LeJiPe/THN132N-BAR626/README.md

##  L'énigme du sphinx Oregon 
## 🛠️ 1 - comment j'ai fini par percer le CRC des sondes THN132N/THN122 avec une carte son
## 🛠️ 2 - Amélioration de la Station BAR626 : Remplacement du Récepteur par un SRX882

## Le problème

Avec des amis, nous possédons tous un récepteur météo Oregon Scientific **BAR626**. Le souci est que ses sondes extérieures d'origine du constructeur — THN132N, THN122,  — tombent en panne au bout de quelques années, et sont aujourd'hui introuvables sur le marché. Les fabricants chinois n'ont jamais copié cette sonde. Aucune sonde du commerce actuelle n'est compatible avec ce récepteur.

Ce n'est pas faute d'avoir cherché du côté de la communauté : sur GitHub et ailleurs, plusieurs personnes butent depuis longtemps sur le calcul du CRC de ces trames. Des tables de relevés partielles existent, mais aucune ne s'est révélée compatible à 100 % avec le récepteur.

Je ne suis ni informaticien ni électronicien de formation. Mais j'avais encore une dernière sonde THN132N vivante, et je me suis dit qu'il devait bien y avoir moyen de comprendre ce qu'Oregon avait imaginé.

## Le robot "Enigma Oregon"

Pour faire parler cette dernière sonde survivante, j'ai construit un robot de test : des potentiomètres à la place des CTN, montés sur des servomoteurs pour balayer un grand nombre de valeurs de température , et des relais pour piloter les canaux.

Le robot a tourné pendant **3 jours** — cliquetis des relais, crissement des servomoteurs, au grand dam de ma femme — et m'a permis de collecter un très grand nombre de trames réelles, émises par une vraie sonde, avec leur CRC correct.

 Robot_Servo

## La chasse au CRC

J'ai commencé par soumettre ce paquet de trames à plusieurs IA, en espérant qu'elles trouvent la formule. Sans succès : "pas assez de données", "calcul trop long", "il faut chercher dans telle direction"... des pistes, jamais de formule magique. Je n'étais visiblement pas le premier à leur poser la question.

J'ai donc changé d'approche. Avec toutes ces trames, j'ai pu isoler facilement les données qui faisaient varier le CRC. Autre constat : le CRC étant codé sur 8 bits, plusieurs trames différentes peuvent partager le même CRC. Plutôt que de chercher sur l'ensemble du jeu de données, j'ai isolé **3 groupes de trames donnant le même CRC** — ce qui réduisait considérablement le champ de recherche d'une formule capable de reproduire ce résultat.

J'ai connecté mes 3 synapses et demandé à l'aide IA de m'écrire des petits programmes en Python (que je ne connais pas) pouvant tourner sur mon petit PC, afin de tester différents algorithmes candidats sur ces groupes. Et un jour, un programme s'arrête : une combinaison donne enfin un résultat identique pour les trois groupes. Le résultat brut n'était pas le bon CRC final, il restait une transformation à trouver — assez simple en fait : un **XOR par 0x59**, suivi d'une **inversion des quartets** (nibbles).

J'ai testé la formule complète sur plusieurs dizaines de trames. Ça marchait.

## La confirmation

Il fallait absolument valider ça sur du matériel réel. J'ai implémenté l'algorithme sur un Arduino, et je l'ai fait émettre vers mon BAR626.

Miracle : le récepteur se synchronise. Je pouvais désormais lui faire afficher n'importe quelle valeur de mon choix sur n'importe quel canal, de -99.9 à 99.9, le récepteur acceptait tout.

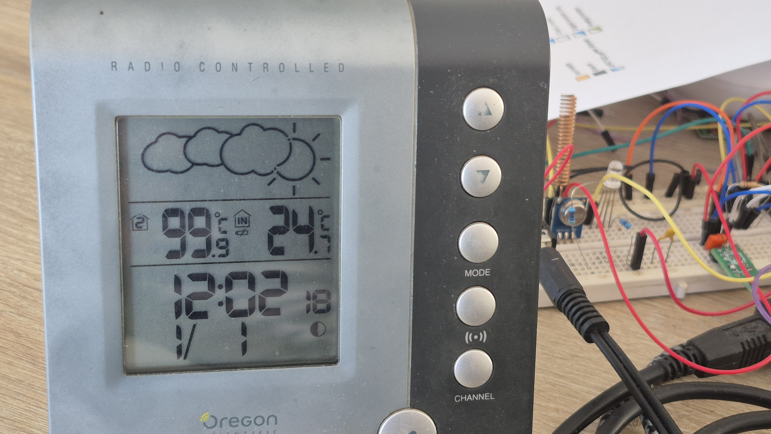
[picture p1: photos/Affiche99_9.jpg]
Affiche 99.9
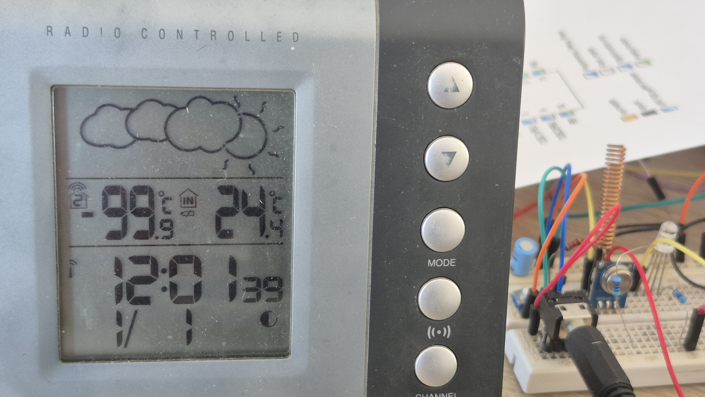
[picture p2: photos/Affiche_-99_9.jpg]
Affiche -99.9
 

## Construire une vraie sonde de remplacement

Fort de cet algorithme, je me suis lancé dans la fabrication d'une sonde de remplacement à base d'un **PIC12F1822** (trouvé dans mes tiroirs) et d'un capteur **TMP117**, dans l'idée de faire quelque chose d'ultra-simple et au moins aussi précis que la sonde d'origine. Le programme a été écrit en assembleur, sous MPLAB.

N'ayant ni oscilloscope ni analyseur logique, j'ai dû ruser pour caler les timings : tous mes relevés de trames ont été faits avec une simple carte son, et j'ai déterminé les timings par superposition entre les trames générées et celles attendues par le récepteur. Le BAR626 s'est révélé très sensible à ces timings, y compris à l'intervalle très précis entre chaque émission — au point que j'ai fini par démonter le récepteur lui-même et enregistrer son activation en fonction de la perte de signal, pour connaître exactement ce qu'il attendait.

Pour le réveil périodique du PIC, j'ai utilisé l'oscillateur interne du watchdog. Résultat : la sonde fonctionnait parfaitement.

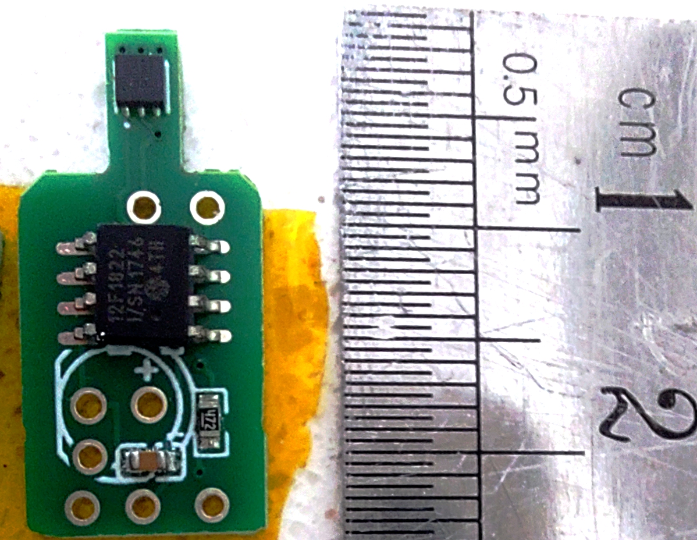
[picture p3: photos/TMP117_PIC12F1822_1.jpg]
PIC12F1822


## Le piège

Content du résultat, j'ai voulu en construire une deuxième pour des amis. Et là, patatras : le timing basé sur le watchdog était complètement dans les choux sur ce deuxième exemplaire. Le système n'était tout simplement pas reproductible d'une puce à l'autre — la dispersion de fréquence de l'oscillateur interne du watchdog était trop grande d'un composant à l'autre.

Il a fallu tout reprendre, en repartant sur un microcontrôleur moderne disposant d'un vrai RTC, en réutilisant la base déjà développée sur Arduino. C'est ce qui a donné naissance au projet actuel, une sonde bâtie autour d'un ATtiny1616.

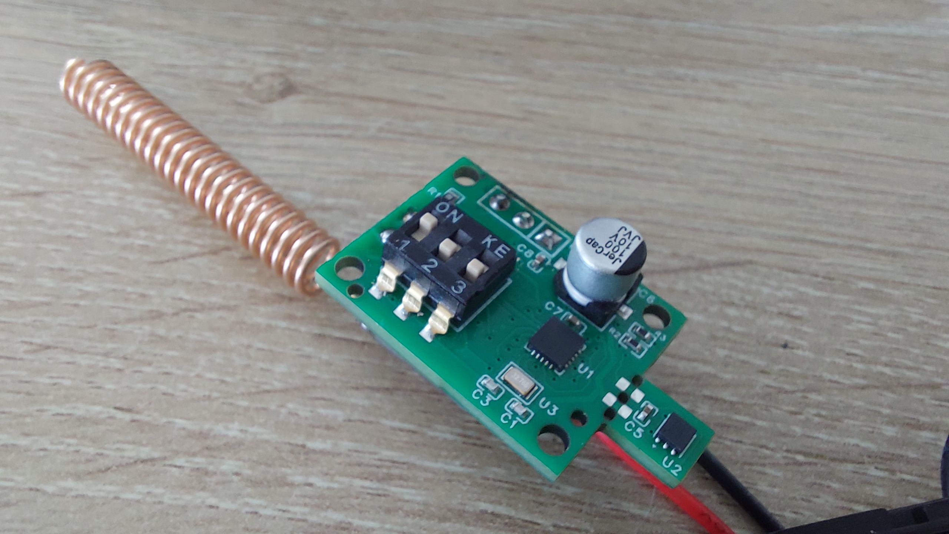
[picture p4: photos/Thn132_Circuit3.jpg]
Circuit3
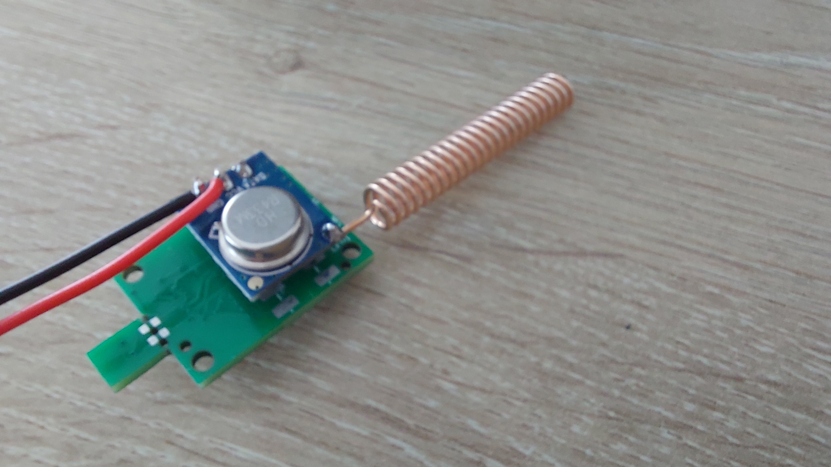
[picture p5: photos/Thn132_Circuit1.jpg]
Circuit1
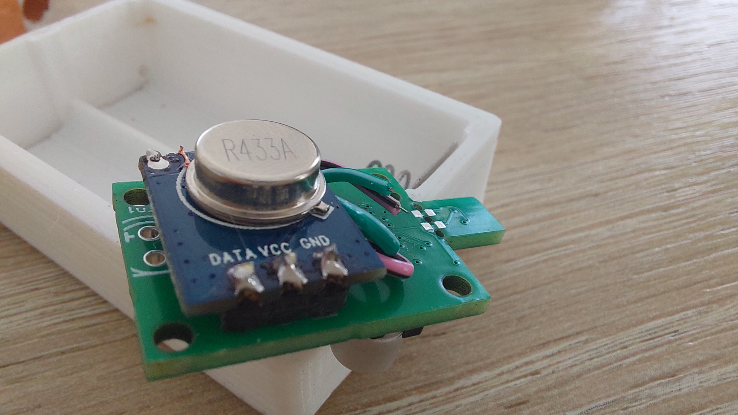
[picture p6: photos/CircuitFafoté_STX882.jpg]
STX882


## Et maintenant

L'algorithme de CRC est validé, la synchronisation avec le BAR626 fonctionne, et la sonde actuelle est plainement opérationnelle. j'y ai ajouté un mode économique, fréquence d'émission des trames divisée  par 2. Plusieurs petites améliorations restent ouvertes : un mécanisme de changement de rollcode (de base fait par numéro de série) modifiable — détection d'une coupure d'alimentation au démarrage dans une fenêtre de 4 à 12 secondes, répétée deux fois, puis addition d'un nombre premier au rollcode — et pourquoi pas une compensation thermique du quartz pour les utilisateurs en environnements très froids.

Si vous vous êtes déjà arraché les cheveux sur ces sondes, j'espère que ce récit — et surtout la formule de CRC — vous fera gagner beaucoup de temps.

## 🛠️ 2 - Amélioration de la Station BAR626 : Remplacement du Récepteur par un SRX882

Le récepteur RF 433 MHz d'origine de la station BAR626 vieillit mal et perd en sensibilité. Le remplacer par un module superhétérodyne moderne **SRX882** permet de retrouver une excellente portée, mais nécessite d'adapter l'alimentation.

### Le défi technique : La limitation de la ligne PWR d'origine
La ligne d'alimentation d'origine du récepteur sur le PCB est limitée à environ 1 mA. Lorsque le SRX882 demande ses ~2,8 mA, cela provoque une chute de tension : **dès que les piles descendent à 3,2 Volts, le récepteur cesse d'être alimenté**.

### La solution matérielle : Alimentation directe et bascule logique via la broche CS
Le récepteur est alimenté directement par le bloc de piles (3xAA), tandis que la broche **CS (Chip Select)** gère les cycles de mise en veille.

<p align="center">
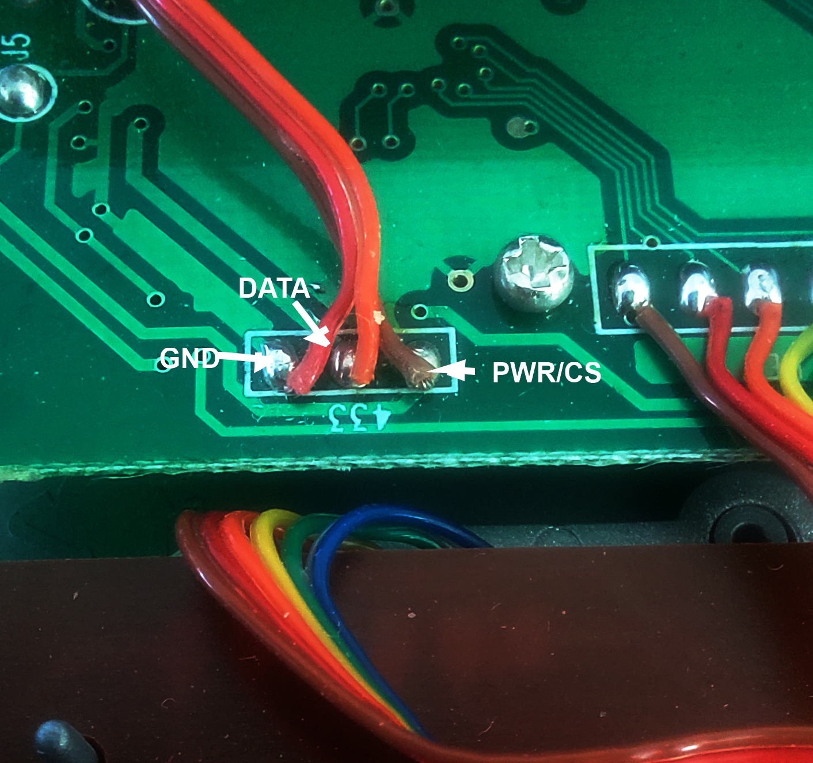
[picture p7: photos/plotsConnexion433.jpg]
Plots de connexion vers le récepteur.
  
  <br><em>Attention le négatif est à gauche, fil rouge !!! </em>
  
</p>

#### Schéma de câblage :
1. **VCC :** Soudé directement sur l'alimentation brute de la batterie (3xAA).
2. **GND :** Connecté à la masse d'origine de la station.
3. **CS (Chip Select) :** Raccordé à l'ancienne piste d'alimentation intermittente (PWR).
4. **Sécurité de veille :** Résistance de **pull-down de 47 kΩ** entre CS et GND.

<p align="center">
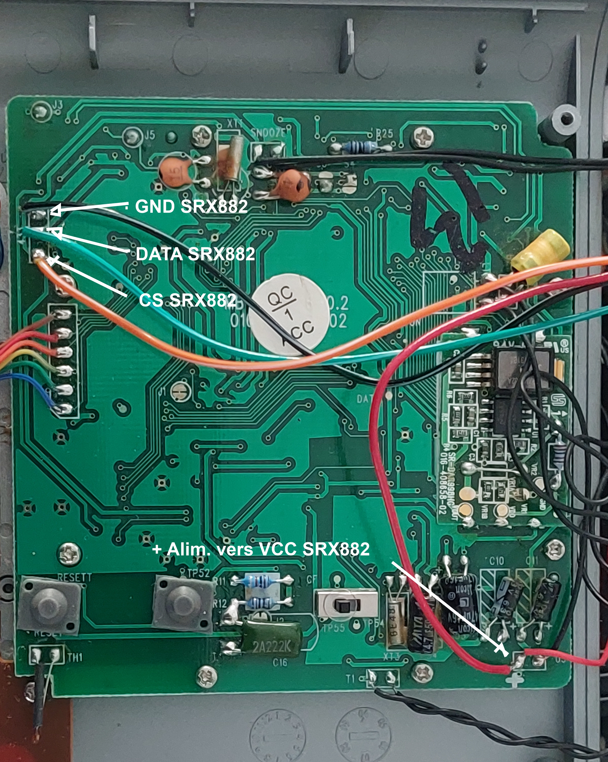
[picture p8: photos/cablage SRX882.jpg]
Points de soudure sur le PCB Oregon
  
  <br><em>Points d'implantation sur le PCB de la BAR626.</em>
</p>

### Résultats et performances
Le récepteur fonctionne désormais de manière stable **jusqu'à 2,8 Volts**.
* **Consommation en veille :** 72 µA
* **Consommation en réception :** 4,12 mA

<p align="center">
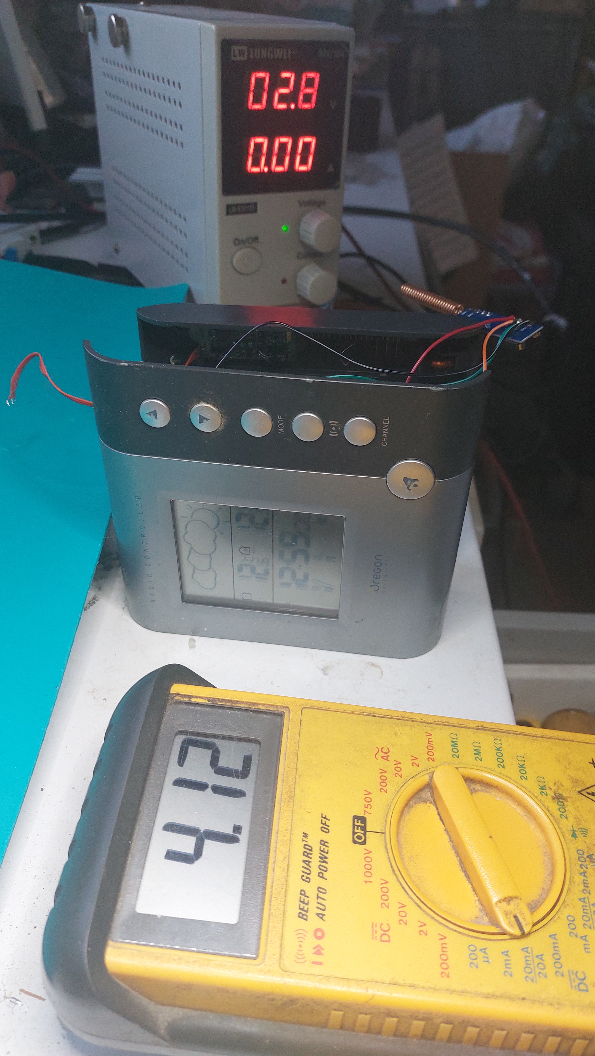
[picture p9: photos/conso_RX_Actif_Alim2800mV.jpg]
Mesures de consommation sur alimentation de labo
  
  <br><em>Validation sur banc de test.</em>
</p>

### Intégration mécanique
Plus compact, le SRX882 se fixe simplement par collage à l'intérieur du boîtier de la BAR626.

<p align="center">
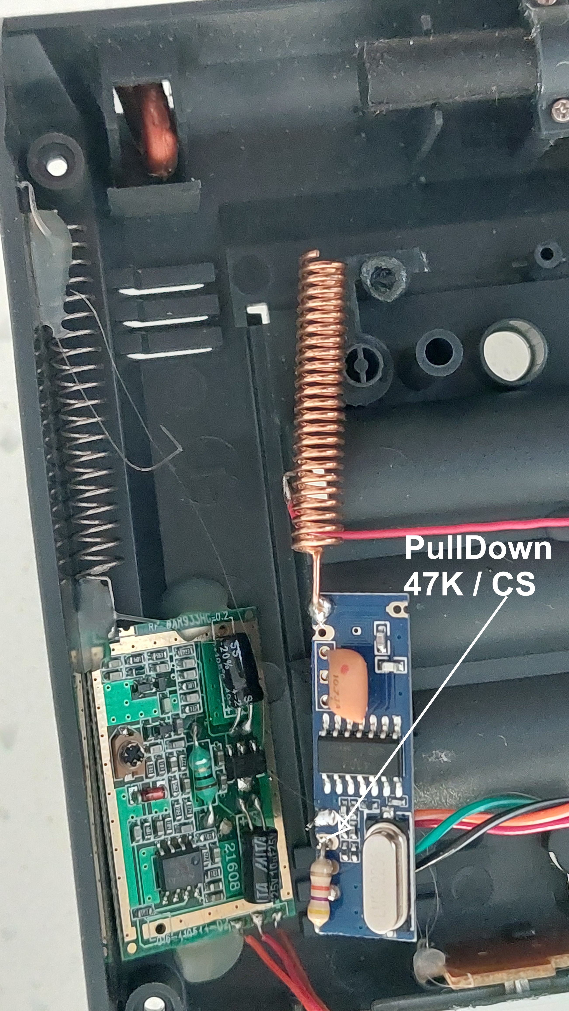
[picture p10: photos/Encombrement.jpg]
Intégration finale du SRX882 dans le boîtier
  
 <br><em>Préparation du SRX882 : Ajout de la résistance de pull-down de 47 kΩ sur la broche CS.</em>
</p>

**Bilan :** L'autonomie s'élève à **environ 10 mois** sur piles AA de 2500 mAh, avec des performances radio grandement améliorées.
