LeJiPe/THN132N-BAR626/photos/2_Piles_AA.jpg

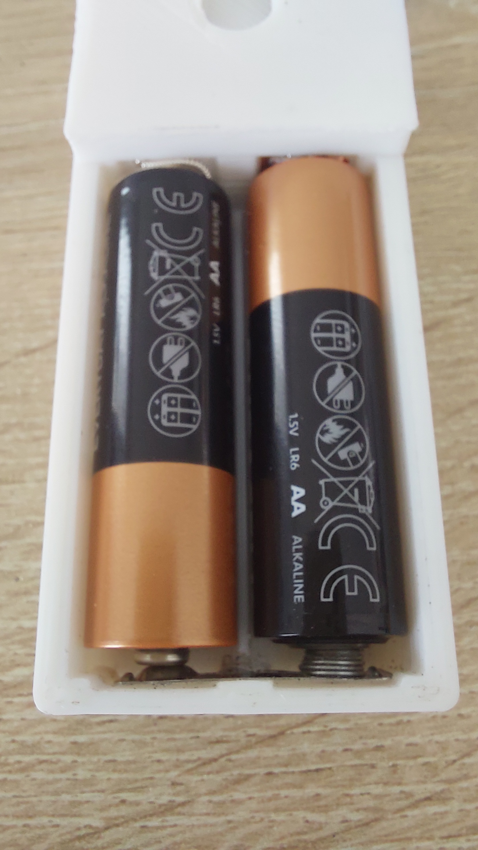
photos/2_Piles_AA.jpg
