LeJiPe/THN132N-BAR626/photos/sondeTHN132N_3D.jpg

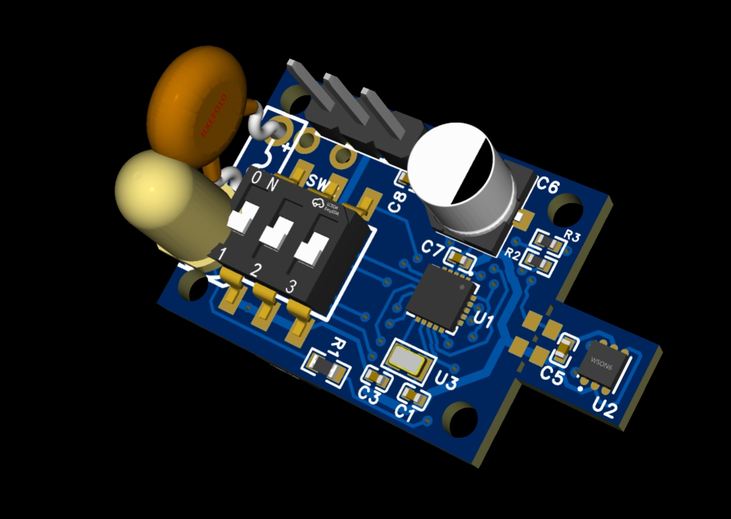
photos/sondeTHN132N_3D.jpg
