LeJiPe/THN132N-BAR626/photos/Soudures_Elts.jpg

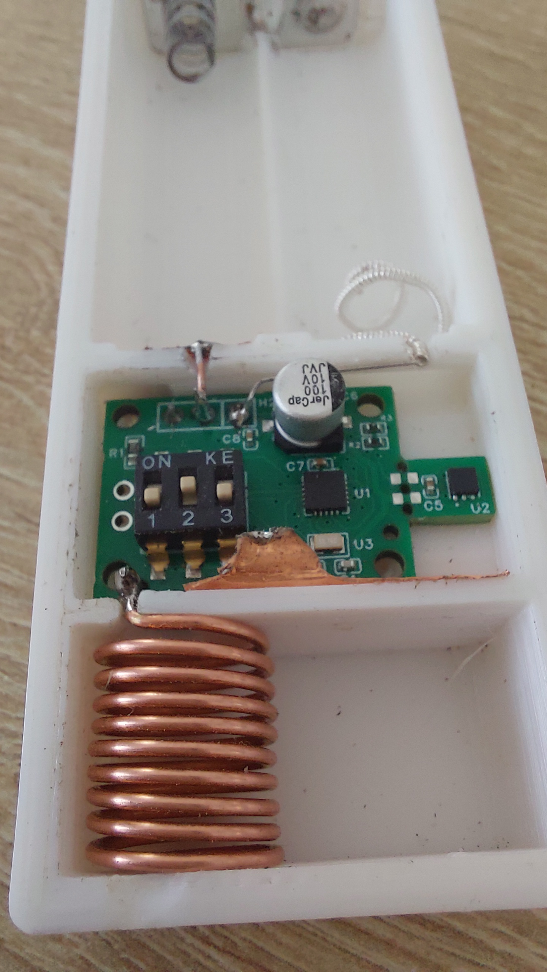
photos/Soudures_Elts.jpg
