LeJiPe/THN132N-BAR626/(commit log)

2026-08-05 Expand README with Oregon Scientific BAR626 project details
    Added detailed explanation of the Oregon Scientific BAR626 and the process of creating a compatible replacement sensor, including challenges faced and solutions implemented.
2026-08-05 Readme.md
    Sonde de précision compatible 100% THN132N THN122. Validé sur récepteur BAR626.
2026-08-05 Update problem description for Oregon Scientific sensors
    Clarified the description of the problem with Oregon Scientific BAR626 weather receiver and its incompatible sensors.
2026-08-07 Update README with clearer explanation of sensor issues
    Clarified the issue with Oregon Scientific BAR626 weather station sensors and their compatibility.
2026-08-07 Update README with image and probe construction details
    Added an image and detailed the construction of a replacement probe using a PIC12F1822 and TMP117 sensor.
2026-08-07 Update README with Arduino implementation details
2026-09-01 Rename test_attiny1616_v3_oregon_4_ino.txt to code/test_attiny1616_v3_oregon_4.ino
    programme Arduino
2026-11-02 Enhance README with BAR626 SRX882 upgrade details
    Added detailed section on upgrading the BAR626 station with SRX882 receiver, including technical challenges, solutions, wiring diagrams, and performance results.
